harshthorat-cpu/PLATYPULSE/PCB/kicad/platy/platy.kicad_pcb

## KiCad design PCB/kicad/platy/platy.kicad_pcb (2026-08-21)

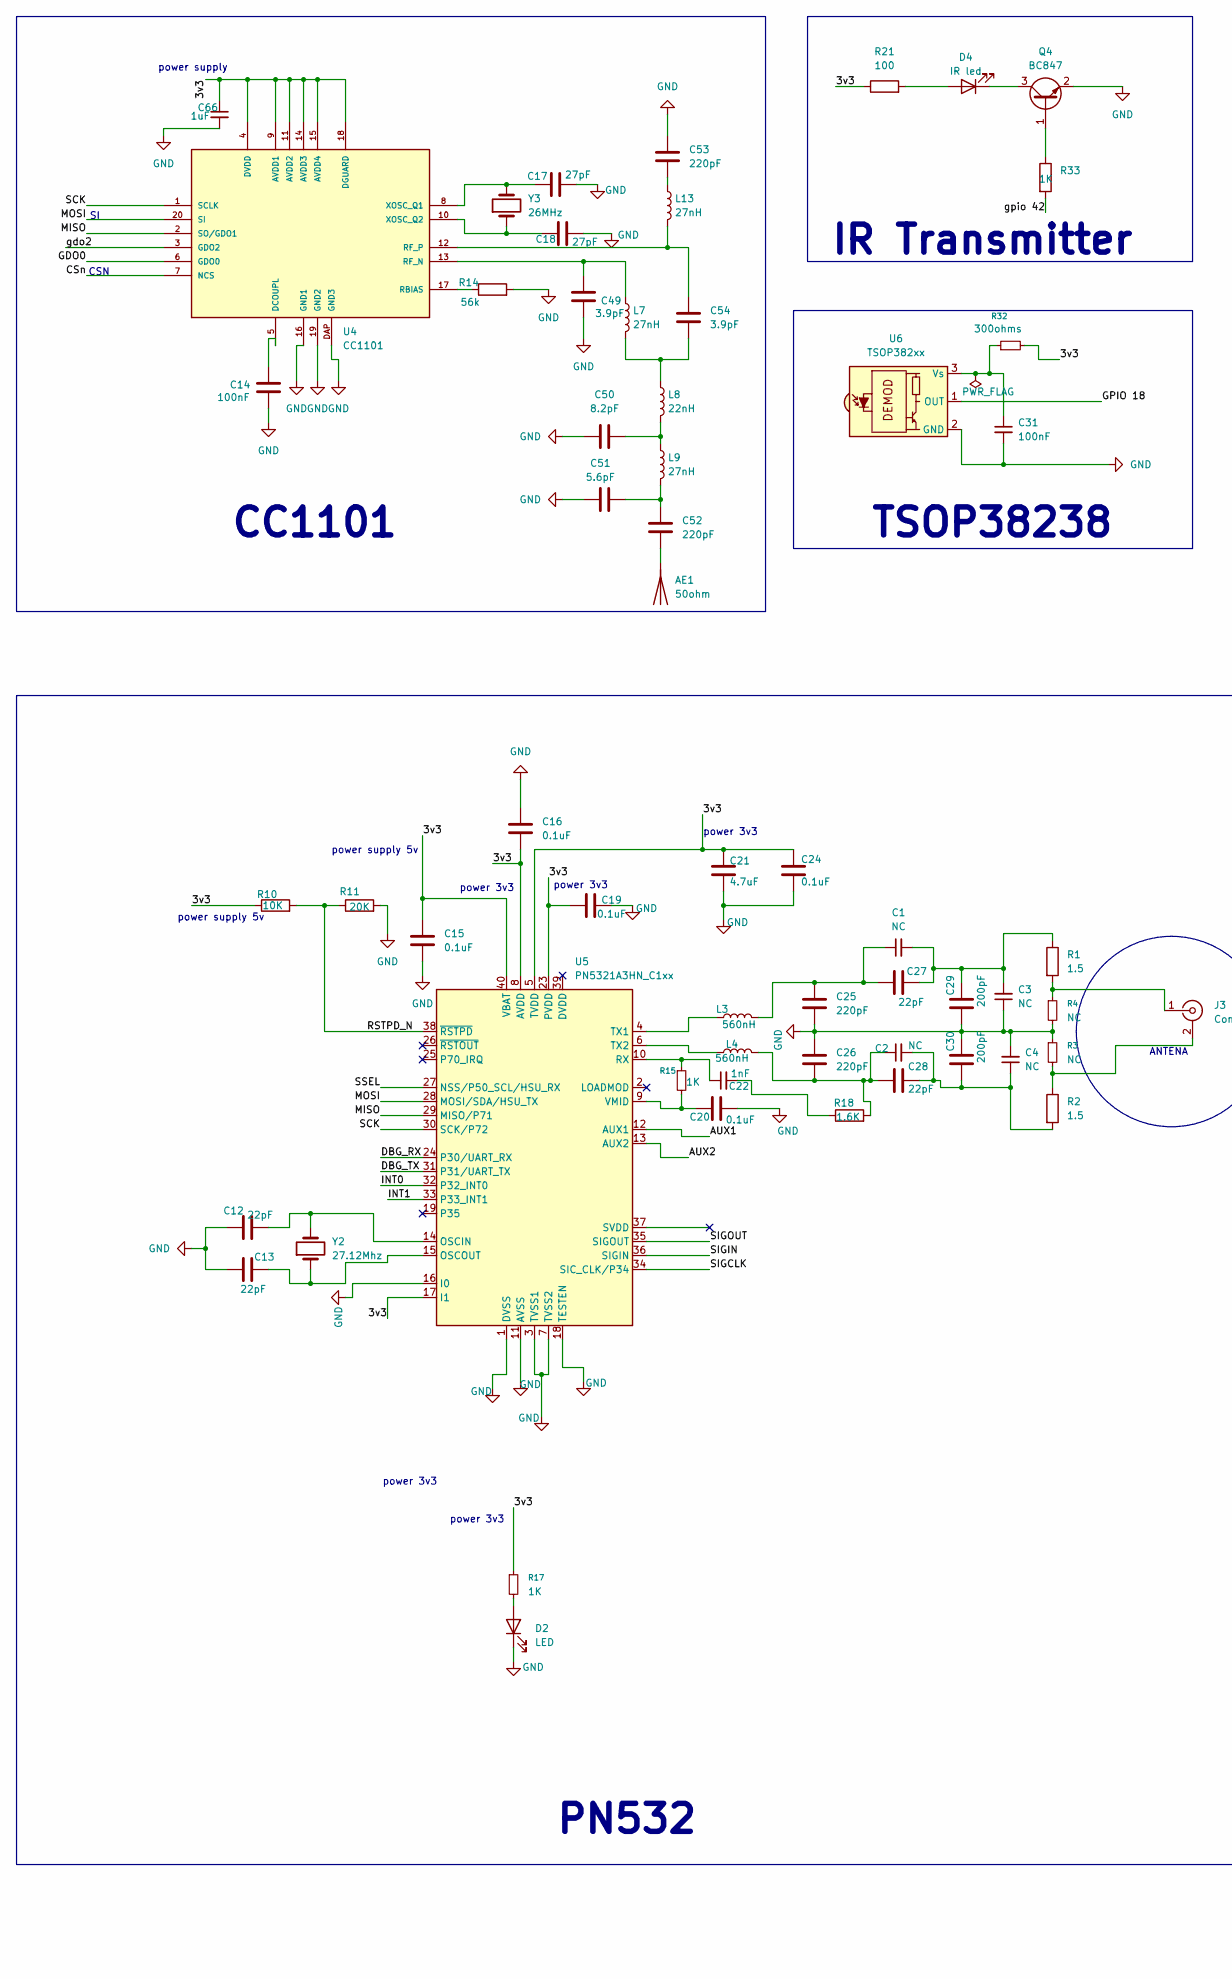
[picture p20: schematic platy.kicad_sch, part in row 1, column 1]

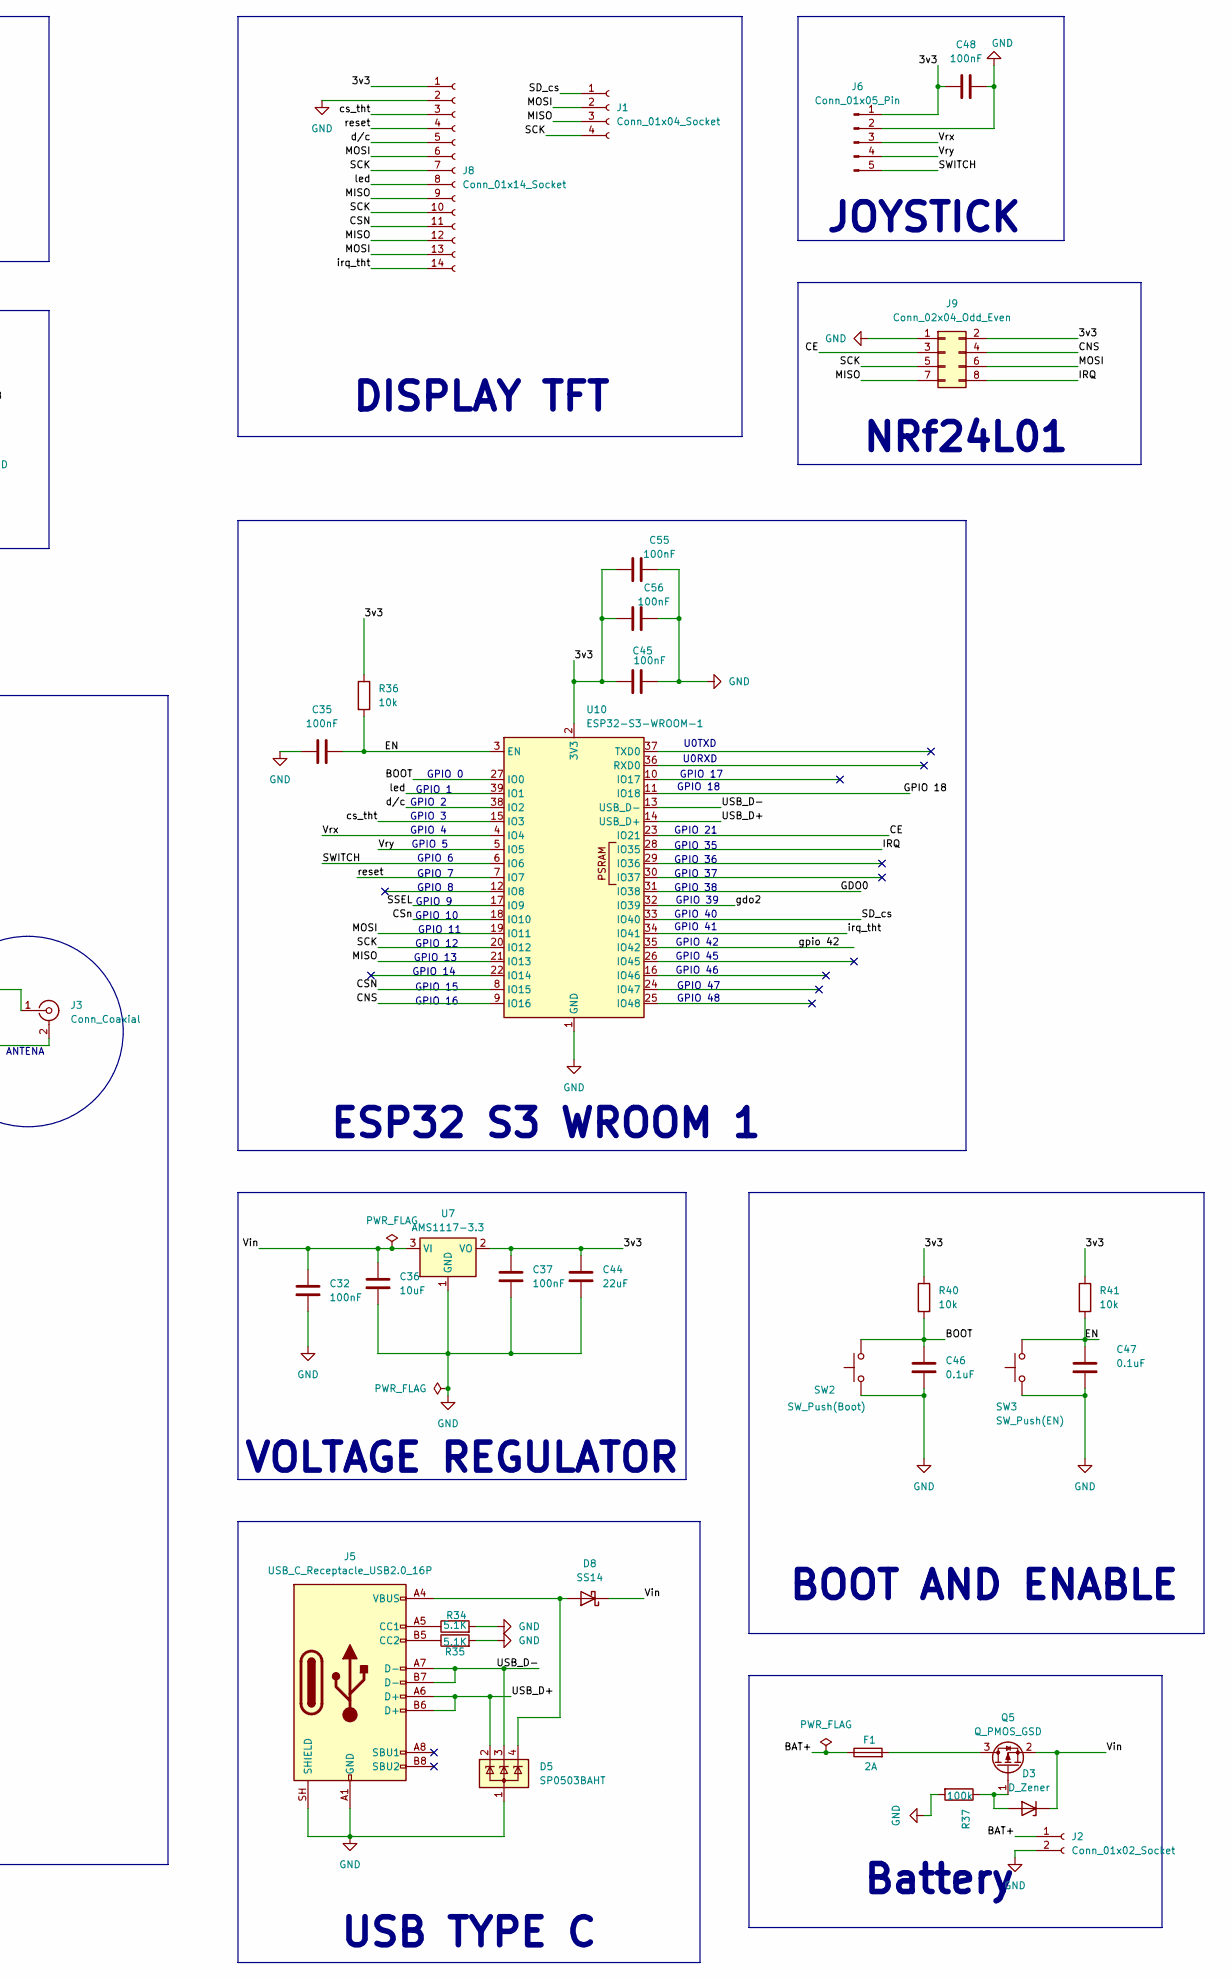
[picture p21: schematic platy.kicad_sch, part in row 1, column 2]

Parts:
AE1: 50ohm; SMA_Amphenol_132134_Vertical
C1, C2, C3, C4: NC; C_0805_2012Metric
C12, C13, C27, C28: 22pF; C_0805_2012Metric
C14, C31, C32, C35, C37, C45, C48, C55, C56: 100nF; C_0805_2012Metric
C15, C16, C19, C20, C24, C46, C47: 0.1uF; C_0805_2012Metric
C17, C18: 27pF; C_0805_2012Metric
C21: 4.7uF; C_0805_2012Metric
C22: 1nF; C_0805_2012Metric
C25, C26, C52, C53: 220pF; C_0805_2012Metric
C29, C30: 200pF; C_0805_2012Metric
C36: 10uF; C_0805_2012Metric
C44: 22uF; C_0805_2012Metric
C49, C54: 3.9pF; C_0805_2012Metric
C50: 8.2pF; C_0805_2012Metric
C51: 5.6pF; C_0805_2012Metric
C66: 1uF; C_0805_2012Metric
D2: LED; LED_0805_2012Metric
D3: D_Zener; D_0805_2012Metric
D4: IR led; LED_D3.0mm
D5: SP0503BAHT; SOT-143
D8: SS14; D_SMA
F1: 2A; Fuse_0805_2012Metric
J1: Conn_01x04_Socket; PinSocket_1x04_P2.54mm_Vertical
J2: Conn_01x02_Socket; JST_EH_S2B-EH_1x02_P2.50mm_Horizontal
J3: Conn_Coaxial; U.FL_Hirose_U.FL-R-SMT-1_Vertical
J5: USB_C_Receptacle_USB2.0_16P; USB_C_Receptacle_GCT_USB4105-xx-A_16P_TopMnt_Horizontal
J6: Conn_01x05_Pin; PinHeader_1x05_P2.54mm_Vertical
J8: Conn_01x14_Socket; PinSocket_1x14_P2.54mm_Vertical
J9: Conn_02x04_Odd_Even; PinSocket_2x04_P2.54mm_Vertical
L3, L4: 560nH; L_0805_2012Metric
L7, L9, L13: 27nH; L_0805_2012Metric
L8: 22nH; L_0805_2012Metric
Q4: BC847; SOT-23
Q5: Q_PMOS_GSD; TSOT-23
R1, R2: 1.5; R_0805_2012Metric
R3, R4: NC; R_0805_2012Metric
R10: 10K; R_0805_2012Metric
R11: 20K; R_0805_2012Metric
R14: 56k; R_0805_2012Metric
R15, R17, R33: 1K; R_0805_2012Metric
R18: 1.6K; R_0805_2012Metric
R21: 100; R_0805_2012Metric
R32: 300ohms; R_0805_2012Metric
R34, R35: 5.1K; R_0805_2012Metric
R36, R40, R41: 10k; R_0805_2012Metric
R37: 100k; R_0805_2012Metric
SW2: SW_Push(Boot); SW_PUSH_6mm
SW3: SW_Push(EN); SW_PUSH_6mm
U4: CC1101; QLP20
U5: PN5321A3HN_C1xx; HVQFN-40-1EP_6x6mm_P0.5mm_EP4.1x4.1mm
U6: TSOP382xx; Vishay_MINICAST-3Pin
U7: AMS1117-3.3; SOT-223-3_TabPin2
U10: ESP32-S3-WROOM-1
Y2: 27.12Mhz; Crystal_SMD_5032-2Pin_5.0x3.2mm
Y3: 26MHz; Crystal_SMD_5032-2Pin_5.0x3.2mm

Connections:
/3v3: C15.1, C16.2, C19.1, C21.1, C24.1, C37.1, C44.1, C45.1, C48.1, C55.1, C56.1, C66.1, J6.1, J8.1, J9.2, R10.1, R17.1, R21.1, R32.2, R36.1, R40.1, R41.1, U4.4 (DVDD), U4.9 (AVDD1), U4.11 (AVDD2), U4.14 (AVDD3), U4.15 (AVDD4), U4.18 (DGUARD), U5.5 (TVDD), U5.8 (AVDD), U5.17 (I1), U5.23 (PVDD), U5.40 (VBAT), U7.2 (VO), U10.2 (3V3)
/AUX1: U5.12 (AUX1)
/AUX2: U5.13 (AUX2)
/BAT+: F1.1, J2.1
/BOOT: C46.1, R40.2, SW2.2, U10.27 (IO0)
/CE: J9.3, U10.23 (IO21)
/CNS: J9.4, U10.9 (IO16)
/CSN: J8.11, U10.8 (IO15)
/CSn: U4.7 (NCS), U10.18 (IO10)
/DBG_RX: U5.24 (P30/UART_RX)
/DBG_TX: U5.31 (P31/UART_TX)
/EN: C35.1, C47.1, R36.2, R41.2, SW3.2, U10.3 (EN)
/GDO0: U4.6 (GDO0), U10.31 (IO38)
/GPIO 18: U6.1 (OUT), U10.11 (IO18)
/INT0: U5.32 (P32_INT0)
/INT1: U5.33 (P33_INT1)
/IRQ: J9.8, U10.28 (IO35)
/MISO: J1.3, J8.9, J8.12, J9.7, U4.2 (SO/GDO1), U5.29 (MISO/P71), U10.21 (IO13)
/MOSI: J1.2, J8.6, J8.13, J9.6, U4.20 (SI), U5.28 (MOSI/SDA/HSU_TX), U10.19 (IO11)
/RSTPD_N: R10.2, R11.1, U5.38 (~RSTPD)
/SCK: J1.4, J8.7, J8.10, J9.5, U4.1 (SCLK), U5.30 (SCK/P72), U10.20 (IO12)
/SD_cs: J1.1, U10.33 (IO40)
/SIGCLK: U5.34 (SIC_CLK/P34)
/SIGIN: U5.36 (SIGIN)
/SIGOUT: U5.35 (SIGOUT)
/SSEL: U5.27 (NSS/P50_SCL/HSU_RX), U10.17 (IO9)
/SWITCH: J6.5, U10.6 (IO6)
/USB_D+: D5.2 (K), J5.A6 (D+), J5.B6 (D+), U10.14 (USB_D+)
/USB_D-: D5.3 (K), J5.A7 (D-), J5.B7 (D-), U10.13 (USB_D-)
/Vin: C32.2, C36.1, D3.1 (K), D8.1 (K), Q5.2 (S), U7.3 (VI)
/Vrx: J6.3, U10.4 (IO4)
/Vry: J6.4, U10.5 (IO5)
/cs_tht: J8.3, U10.15 (IO3)
/d/c: J8.5, U10.38 (IO2)
/gdo2: U4.3 (GDO2), U10.32 (IO39)
/gpio 42: R33.2, U10.35 (IO42)
/irq_tht: J8.14, U10.34 (IO41)
/led: J8.8, U10.39 (IO1)
/reset: J8.4, U10.7 (IO7)
GND: C3.1, C4.2, C12.2, C13.1, C14.2, C15.2, C16.1, C17.2, C18.2, C19.2, C20.2, C21.2, C24.2, C25.2, C26.1, C29.1, C30.2, C31.2, C32.1, C35.2, C36.2, C37.2, C44.2, C45.2, C46.2, C47.2, C48.2, C49.1, C50.2, C51.2, C53.2, C55.2, C56.2, C66.2, D2.1 (K), D5.1 (A), J2.2, J5.A1 (GND), J5.A12 (GND), J5.B1 (GND), J5.B12 (GND), J5.SH (SHIELD), J6.2, J8.2, J9.1, Q4.2 (E), R3.1, R4.2, R11.2, R14.2, R34.2, R35.2, R37.2, SW2.1, SW3.1, U4.16 (GND1), U4.19 (GND2), U4.DAP (GND3), U5.1 (DVSS), U5.3 (TVSS1), U5.7 (TVSS2), U5.11 (AVSS), U5.16 (I0), U5.18 (TESTEN), U5.41 (AVSS), U6.2 (GND), U7.1 (GND), U10.1 (GND), U10.40 (GND), U10.41 (GND)
unnamed: AE1.1 (A_1), C52.1
unnamed: C1.1, C25.1, C27.1, L3.2
unnamed: C1.2, C3.2, C27.2, C29.2, R1.1
unnamed: C2.1, C26.2, C28.1, L4.2, R18.2
unnamed: C2.2, C4.1, C28.2, C30.1, R2.2
unnamed: C22.2, R18.1
unnamed: C50.1, L8.2, L9.1
unnamed: C51.1, C52.2, L9.2
unnamed: C53.1, L13.1
unnamed: C54.1, L7.2, L8.1
unnamed: D2.2 (A), R17.2
unnamed: D3.2 (A), Q5.1 (G), R37.1
unnamed: D4.2 (A), R21.2
unnamed: D4.1 (K), Q4.3 (C)
unnamed: D5.4 (K), D8.2 (A), J5.A4 (VBUS), J5.A9 (VBUS), J5.B4 (VBUS), J5.B9 (VBUS)
unnamed: J3.2 (Ext), R2.1, R3.2
unnamed: J3.1 (In), R1.2, R4.1
unnamed: J5.A5 (CC1), R34.1
unnamed: J5.B5 (CC2), R35.1
unnamed: Q4.1 (B), R33.1
unnamed: F1.2, Q5.3 (D)
unnamed: C14.1, U4.5 (DCOUPL)
unnamed: R14.1, U4.17 (RBIAS)
unnamed: C49.2, L7.1, U4.13 (RF_N)
unnamed: C54.2, L13.2, U4.12 (RF_P)
unnamed: C17.1, U4.8 (XOSC_Q1), Y3.2
unnamed: C18.1, U4.10 (XOSC_Q2), Y3.1
unnamed: C12.1, U5.14 (OSCIN), Y2.2
unnamed: C13.2, U5.15 (OSCOUT), Y2.1
unnamed: C22.1, R15.1, U5.10 (RX)
unnamed: L3.1, U5.4 (TX1)
unnamed: L4.1, U5.6 (TX2)
unnamed: C20.1, R15.2, U5.9 (VMID)
unnamed: C31.1, R32.1, U6.3 (Vs)

Notes on the sheet:
GPIO 3
GPIO 45
GPIO 36
power 3v3
GPIO 38
GPIO 13
GPIO 46
GPIO 47
GPIO 48
GPIO 0
GPIO 4
U0TXD
power supply
PN532
GPIO 9
GPIO 17
GPIO 18
BOOT AND ENABLE
GPIO 37
U0RXD
GPIO 14
GPIO 2
JOYSTICK
TSOP38238
GPIO 1
GPIO 42
GPIO 8
CC1101
GPIO 12
GPIO 11
CSN
power supply 5v
DISPLAY TFT
ANTENA
IR Transmitter
GPIO 35
GPIO 40
Battery
GPIO 6
ESP32 S3 WROOM 1
GPIO 21
VOLTAGE REGULATOR
USB TYPE C
GPIO 10
GPIO 7
GPIO 39
GPIO 16
NRf24L01
GPIO 41
GPIO 5
GPIO 15

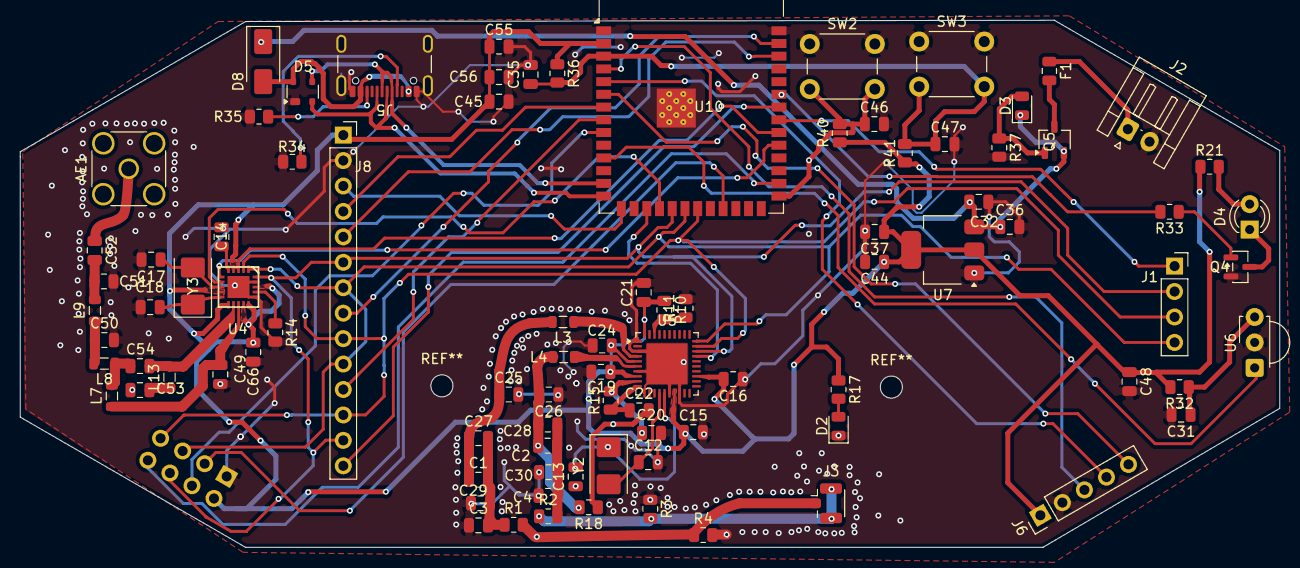
[picture p22: board platy.kicad_pcb from above]

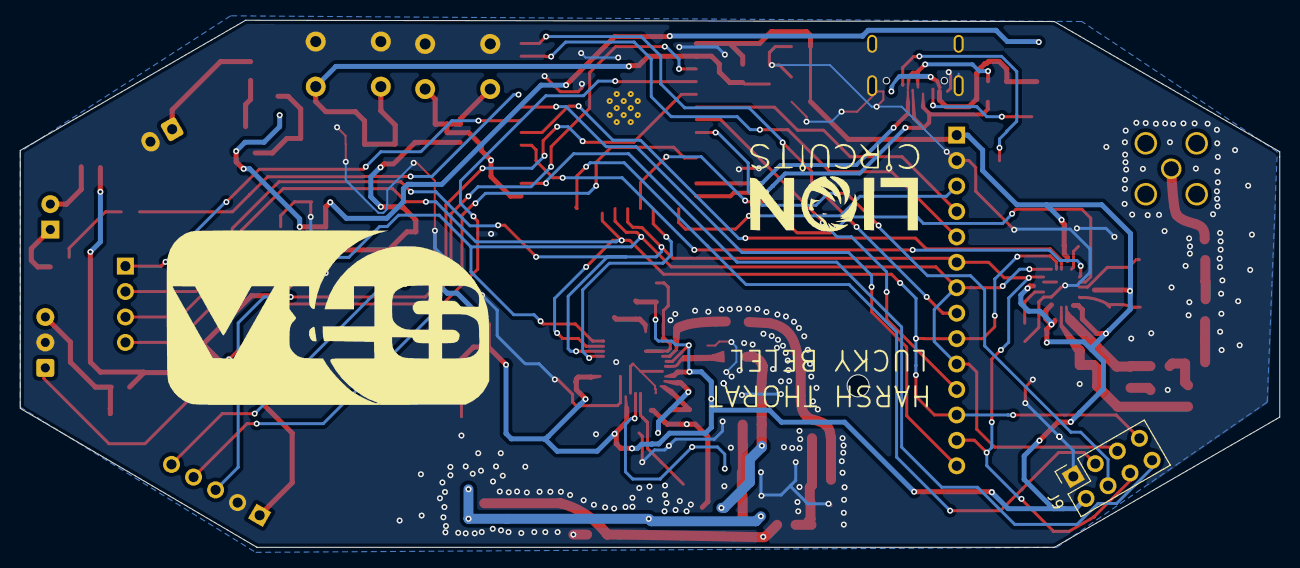
[picture p23: board platy.kicad_pcb from below]

Board: 2 copper layers, 125.8 x 52.6 mm, 92 parts (2 on the bottom side), 65 nets.

Other parts of the board:
lionckt: LOGO
