harshthorat-cpu/PLATYPULSE/Firmware/UI/ui_control/test/main/Perry_the_platypus.c

#ifdef __has_include
    #if __has_include("lvgl.h")
        #ifndef LV_LVGL_H_INCLUDE_SIMPLE
            #define LV_LVGL_H_INCLUDE_SIMPLE
        #endif
    #endif
#endif

#if defined(LV_LVGL_H_INCLUDE_SIMPLE)
    #include "lvgl.h"
#else
    #include "lvgl/lvgl.h"
#endif


#ifndef LV_ATTRIBUTE_MEM_ALIGN
#define LV_ATTRIBUTE_MEM_ALIGN
#endif

#ifndef LV_ATTRIBUTE_IMAGE_PERRY_THE_PLATYPUS
#define LV_ATTRIBUTE_IMAGE_PERRY_THE_PLATYPUS
#endif

const LV_ATTRIBUTE_MEM_ALIGN LV_ATTRIBUTE_LARGE_CONST LV_ATTRIBUTE_IMAGE_PERRY_THE_PLATYPUS uint8_t Perry_the_platypus_map[] = {
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
};

const lv_image_dsc_t Perry_the_platypus = {
  .header.cf = LV_COLOR_FORMAT_RGB565,
  .header.magic = LV_IMAGE_HEADER_MAGIC,
  .header.w = 128,
  .header.h = 160,
  .data_size = 20480 * 2,
  .data = Perry_the_platypus_map,
};
